Bastardkb/splinktegrated/(threads)

Thread 1 (2022-12-19):

todo

bstiq, 2022-12-19:
- [x] use usb-c C963373
- [x] remove reset buttons, all of them... leave 4 pads exposed
- [x] move 3.3V voltage regulator so it doesn't clash with the USB
- [x] route 3.3v to serial port (instead of 5v)
- [x] route 3.3v to rgb and trackball
- [x] make left/right easier to differentiate: jumper, reset button, usb-c
- [x] flip jumper

bstiq, 2023-02-21:
fixed as of 1.1

Closed 2023-02-21.

Thread 3 (2023-03-31):

Get rid of jumper

bstiq, 2023-03-31:
Idea: use 2 voltage regulators, with diodes, to connect the correct side of the audio jack to 3v3
Get rid of jumper this way

Closed 2023-05-17.

Thread 4 (2023-04-04):

Better serial protection

bstiq, 2023-04-04:
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

https://discord.com/channels/681309835135811648/747849854276993114/1075405422913142824

Because we are using 3.3v for power, no need for power protection. Only data line.

bstiq, 2023-04-22:
Just confirmed R6 stops the serial from communicating properly.
Maybe the pullup is necessary ?

TODO - add 2 footprints for those 2 resistors, and a jumper for serial, to test in the batch and worst case can salvage them

bstiq, 2023-04-22:
according to this comment: https://github.com/qmk/qmk_firmware/blob/4020674163fc80914059c4c9c3be5c0ae00bd150/platforms/chibios/drivers/vendor/RP/RP2040/serial_vendor.c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

it would need custom code - NO GO, get rid of the resistor

bstiq, 2023-04-23:
solved as of 1.31

Closed 2023-04-23.

Thread 8 (2023-10-02):

1.4

bstiq, 2023-10-02:
- [x] update silkscreen / fonts
- [x] add fpc connector
- [x] move memory
- [x] panelize
- [x] update m4 holes like on the dilemma
- [x] remove rst header
- [x] add trackball connector to bottom
- [ ] handedness pin
- [x] add big left/right at bottom
- [x] copy update silkscreen from dilemma
- [ ] 4.7k resistor on handedness pin

bstiq, 2023-10-12:
rework silkscreen, make it clear 2 jumpers + rst btn need to be soldered:
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

Closed 2023-12-11.

Thread 14 (2024-05-22):

C3 connection

bstiq, 2024-05-22:
I've had a few reports of the C3 connection randomly dying.

It might be structurally fragile.

bstiq, 2024-08-28:
waiting on zmk feedback, not sure yet if the serial connection requires crossed pins. If so, move the second jumper to the bottom "dev" zone:

> 1 jumper for qmk half-duplex, and 2 jumpers for ZMK or crossed-over QMK

bstiq, 2025-03-31:
note over usb-c (from Karlk90):

Just keep the GND and VBUS pins assignment and do serial tx/rx over the d+ and d- lines. No risk of shorts and if someone plugs in the split interconnect into their pc it doesn't short anything and will just appear as a faulty usb device as it doesn't actually speak usb.

bstiq, 2025-04-01:
so re:switching to full duplex and keeping TRRS
user:
+ can have it soon :tm:
+ fixes (hopefully) hotplug issues
+ move away from half duplex
- half baked, no usb-c
- requires TRRS cables instead of TRS

vendor:
+ way easier to transition to than usb-c interconnect (3d cases etc)
+ new and old pcb hardware is not compatible
+ prepares the firmware for future usb-c interconnect with full duplex
- firmware backwards compatibility remains an unknown

conclusion: better have something soon that helps, even if it's not perfect, than nothing for another year or 2?

TODO list:
x order resistors
_ test full duplex firmware
_ test full duplex/half duplex runtime firmware
_ short data lines together
_ short data lines with vcc, gnd
_ design and order splinktegrated revision with visible differences (v2 vs v3)

Thread 15 (2025-08-08):

Bad JLCPCB Placement on latest version?

stratosgear, 2025-08-08:
I was trying to get me some splinktegrateds and I put the latest version on JLCPCB for assembly.

Apart from missing some parts, I got this preview:

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

that doesn't look right.

It's the first time I ordered assembled parts from JLCPCB (actually the first time I am trying to order anything from there) so I do not know if I messed up or if your latest version is somehow borked?

Also, if you do not mind me asking, what kind of shipping options do you usually select, or you would suggest?  Not for a huge order that you might be making when restocking your shop, but for a 5 parts minimum order if I wanted to build a couple of keyboards. Delivery time is not that critical, but I do not want to pay double for taxes with surprise fees if I pick the wrong S/H option.  All their S/H and tax info are confusing me.  I would be shipping to Spain, btw...!

Thanks!

bstiq, 2025-08-09:
Hello,

It seems like you ordered version 3.0.
This one is marked as pre-release, and brings a number of upgrades like dual USB-C, improved serial protection.
It has not been tested yet.

On top of that, none of my 3d models account for that new usb-c serial port, so the PCB won't be compatible with any of the BK cases.

If you order Splinktegrated PCBs, I recommend instead getting the latest stable version, which would be 1.4.

Re: shipping options, there's 3 ways of doing it, which are detailed on the payment page of JLC. Pre-pay taxes, have the shipping company manage it for you (they usually add a fee on top of that), or use your own contract. In my experience, pre-paid means shipping is more expensive but gets there a lot faster. In any case you won't be able to avoid paying those 21%-ish import taxes,

Cheers!

stratosgear, 2025-08-09:
Actually it seems it let's me continue, but there are still missing parts:

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

searching for alternatives:

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

And I do not know that substitutes to choose (if any)!

I guess, at this point, it seems that I cannot order one, unless you make a pass by JCLPCB and check it yourself!  I was really interested to see how much it would actually cost me, or if I should just go ahead and handwire a rp2040 zero myself.  But I really wanted a way to properly mount it on the case, too, which Splinktegrated would nicely mount.   Anyways, beggars can't be choosers, I guess!!

Thanks once again!

Closed 2025-08-09.
