Bastardkb/splinktegrated/(commit log)

2022-12-14 remove buttons
    [splinky-shield.kicad_pcb, splinky-shield.kicad_sch]
2022-12-14 rst button both sides...
    [splinky-shield.kicad_pcb]
2022-12-14 rst button :(
    [splinky-shield.kicad_pcb]
2022-12-19 move daughterboard components to accomodate usb-c
    [splinky-shield.kicad_pcb]
2022-12-19 power traces
    [splinky-shield.kicad_pcb]
2022-12-20 add back rst button
    [splinky-shield.kicad_pcb]
2022-12-20 license stuff
    [splinky-shield.kicad_sch]
2022-12-28 change project name, add vcuts
    [splinktegrated.kicad_pcb, splinktegrated.kicad_sch]
2022-12-28 update bom
    [splinktegrated.kicad_pcb]
2022-12-28 detrompeur ESD
    [splinktegrated.kicad_pcb]
2022-12-28 move detrompeur
    [splinktegrated.kicad_pcb]
2023-01-08 move esd chip
    [splinktegrated.kicad_pcb]
2023-01-09 move diode
    [splinktegrated.kicad_pcb]
2023-02-21 route 3.3V
    [splinktegrated.kicad_pcb, splinktegrated.kicad_sch]
2023-02-21 update version number
    [splinktegrated.kicad_pcb]
2023-03-13 thermal releifs gnd
    [splinktegrated.kicad_pcb]
2023-03-15 bigger thermal reliefs
    [splinktegrated.kicad_sch]
2023-03-17 vcc 0.3mm
    [splinktegrated.kicad_pcb]
2023-03-21 0.2mm thermal reliefs
    [splinktegrated.kicad_pcb]
2023-03-21 exclude components from BOM
    [splinktegrated.kicad_pcb, splinktegrated.kicad_sch]
2023-04-05 memory, data line protection
    [splinktegrated.kicad_pcb, splinktegrated.kicad_sch]
2023-04-23 remove serial resistor
    [splinktegrated.kicad_pcb, splinktegrated.kicad_sch]
2023-10-02 add fpc connector
    [splinktegrated.kicad_pcb, splinktegrated.kicad_sch]
2023-10-03 flip connectors
    [splinktegrated.kicad_pcb]
2023-10-03 screw holes
    [splinktegrated.kicad_pcb, splinktegrated.kicad_sch]
2023-10-03 assembly / non assembly labels
    [splinktegrated.kicad_sch]
2023-10-03 remove RST header
    [splinktegrated.kicad_pcb, splinktegrated.kicad_sch]
2023-10-03 fix usb c pad clearance
    [splinktegrated.kicad_pcb]
2023-10-04 fix non solderable tht on daughterboard
    [splinktegrated.kicad_pcb]
2023-10-06 add trackball connector
    [splinktegrated.kicad_pcb, splinktegrated.kicad_sch]
2023-10-08 connect trackball jst
    [splinktegrated.kicad_pcb]
2023-10-12 add hands header
    [splinktegrated.kicad_pcb, splinktegrated.kicad_sch]
2023-11-10 remove handedness pin
    [splinktegrated.kicad_pcb, splinktegrated.kicad_sch]
2024-08-28 add second jumper for full duplex
    [splinktegrated.kicad_pcb, splinktegrated.kicad_sch]
2024-08-28 start implementing vik
    [splinktegrated.kicad_sch]
2024-08-28 add criss crossed jumpers for full duplex
    [splinktegrated.kicad_pcb, splinktegrated.kicad_sch]
2024-08-29 add 5v jumper
    [splinktegrated.kicad_pcb, splinktegrated.kicad_sch]
2024-09-06 add 2 breakout pins
    [splinktegrated.kicad_pcb, splinktegrated.kicad_sch]
2024-09-10 add ESD protection on second serial pin
    [splinktegrated.kicad_pcb, splinktegrated.kicad_sch]
2025-01-06 fix missing ss connection
    [splinktegrated.kicad_pcb]
2025-01-06 add pin
    [splinktegrated.kicad_sch]
2025-01-30 add hands jumper
    [splinktegrated.kicad_pcb, splinktegrated.kicad_sch]
2025-01-30 handedness resistor
    [splinktegrated.kicad_pcb, splinktegrated.kicad_sch]
2025-01-30 hide resistor silkscreen
    [splinktegrated.kicad_pcb]
2025-02-19 remove full duplex jumper
    [splinktegrated.kicad_pcb, splinktegrated.kicad_sch]
2025-02-19 additional hotplug protection
    [splinktegrated.kicad_pcb, splinktegrated.kicad_sch]
2025-03-14 remove serial resistors
    [splinktegrated.kicad_pcb]
2025-03-14 remove resistors from schematic
    [splinktegrated.kicad_pcb, splinktegrated.kicad_sch]
2025-03-19 thick vik logo
    [splinktegrated.kicad_pcb]
2025-05-09 remove additional serial protection
    [splinktegrated.kicad_pcb]
2025-05-09 add trrs serial jumpers
    [splinktegrated.kicad_pcb, splinktegrated.kicad_sch]
2025-05-09 move esd chip closer to rp pin
    [splinktegrated.kicad_pcb, splinktegrated.kicad_sch]
2025-05-09 move vik logo
    [splinktegrated.kicad_pcb]
2025-05-16 second serial line
    [splinktegrated.kicad_pcb, splinktegrated.kicad_sch]
2025-05-16 non reversible
    [splinktegrated.kicad_pcb, splinktegrated.kicad_sch]
2025-05-16 Revert "non reversible"
    This reverts commit 0938fd5d7652574ba26fdcc387b61703472ae386.
    [splinktegrated.kicad_pcb, splinktegrated.kicad_sch]
2025-07-25 start rerouting
    [splinktegrated.kicad_pcb]
2025-07-29 move to usb c serial
    [splinktegrated.kicad_pcb, splinktegrated.kicad_sch]
2025-07-29 5V interconnect
    [splinktegrated.kicad_pcb, splinktegrated.kicad_sch]
2025-07-29 move components around
    [splinktegrated.kicad_sch]
2025-07-29 BOM work
    [splinktegrated.kicad_sch]
2025-07-29 placement and routing
    [splinktegrated.kicad_pcb, splinktegrated.kicad_sch]
2025-07-29 add ferrite on main connection
    [splinktegrated.kicad_pcb]
2025-07-29 add serial breakout
    [splinktegrated.kicad_pcb, splinktegrated.kicad_sch]
2025-07-29 bigger vias
    [splinktegrated.kicad_pcb]
2025-07-30 move components
    [splinktegrated.kicad_pcb]
2025-08-12 replace zener with TVS
    [splinktegrated.kicad_pcb, splinktegrated.kicad_sch]
2025-08-12 add 5v level shifter for RGB
    [splinktegrated.kicad_pcb, splinktegrated.kicad_sch]
2025-08-12 add notes
    [splinktegrated.kicad_sch]
2025-08-12 5V rgb label
    [splinktegrated.kicad_pcb]
2025-08-12 ERC DRC
    [splinktegrated.kicad_pcb, splinktegrated.kicad_sch]
2025-08-12 move silkscreen
    [splinktegrated.kicad_pcb]
2025-09-11 right left
    [splinktegrated.kicad_pcb, splinktegrated.kicad_sch]
2025-09-11 move things
    [splinktegrated.kicad_pcb]
2025-09-12 route left side
    [splinktegrated.kicad_pcb]
2025-09-12 vik logo
    [splinktegrated.kicad_pcb]
2025-09-18 remove outside panelling
    [splinktegrated.kicad_pcb]
2025-09-23 Revert "remove outside panelling"
    This reverts commit 38a877c3f8acecfc4239cec6ccd43cc93e6b331c.
    [splinktegrated.kicad_pcb]
2025-11-03 start renaming right side labels for later incorporation
    [splinktegrated.kicad_pcb, splinktegrated.kicad_sch]
2025-11-03 start renaming nets
    [splinktegrated.kicad_pcb, splinktegrated.kicad_sch]
2025-11-03 connect everything together
    [splinktegrated.kicad_pcb, splinktegrated.kicad_sch]
2025-11-03 add mousebite footprint
2025-11-03 drc erc
    [splinktegrated.kicad_pcb, splinktegrated.kicad_sch]
2025-11-07 remove hands jumpers
    [splinktegrated.kicad_pcb, splinktegrated.kicad_sch]
2025-11-07 move everything back up
    [splinktegrated.kicad_pcb, splinktegrated.kicad_sch]
2025-11-07 connect stuff
    [splinktegrated.kicad_pcb, splinktegrated.kicad_sch]
2025-11-14 rotate left side FPC
    [splinktegrated.kicad_pcb]
2025-12-24 change push button
    [splinktegrated.kicad_pcb, splinktegrated.kicad_sch]
2025-12-24 populate hardware fallback button
    [splinktegrated.kicad_sch]
2026-01-20 switch to 2 layers
    [splinktegrated.kicad_pcb]
2026-06-09 add tvs diodes... so many of them
    [splinktegrated.kicad_pcb, splinktegrated.kicad_sch]
2026-09-10 vbus on serial esd pin
    [splinktegrated.kicad_pcb, splinktegrated.kicad_sch]
