Bastardkb/splinktegrated/(notices)

Notices in the files:
splinky-shield.kicad_pcb:
CERN-OHL-S v2
